bricofoy/groupe/kicad/groupe2/groupe2.png

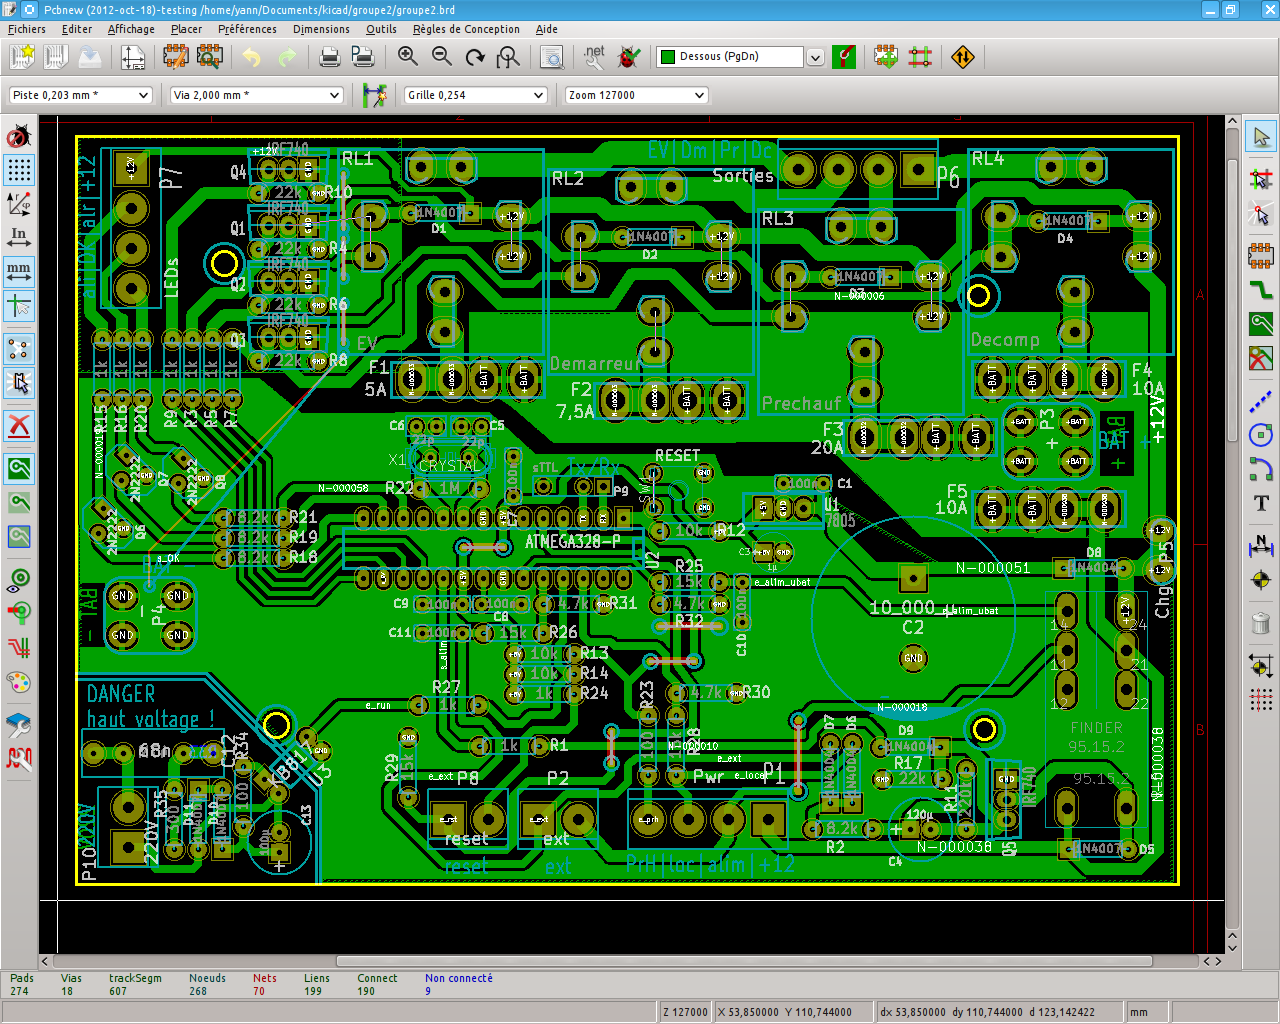
kicad/groupe2/groupe2.png
