bricofoy/groupe/kicad/groupe2/groupe2.pdf

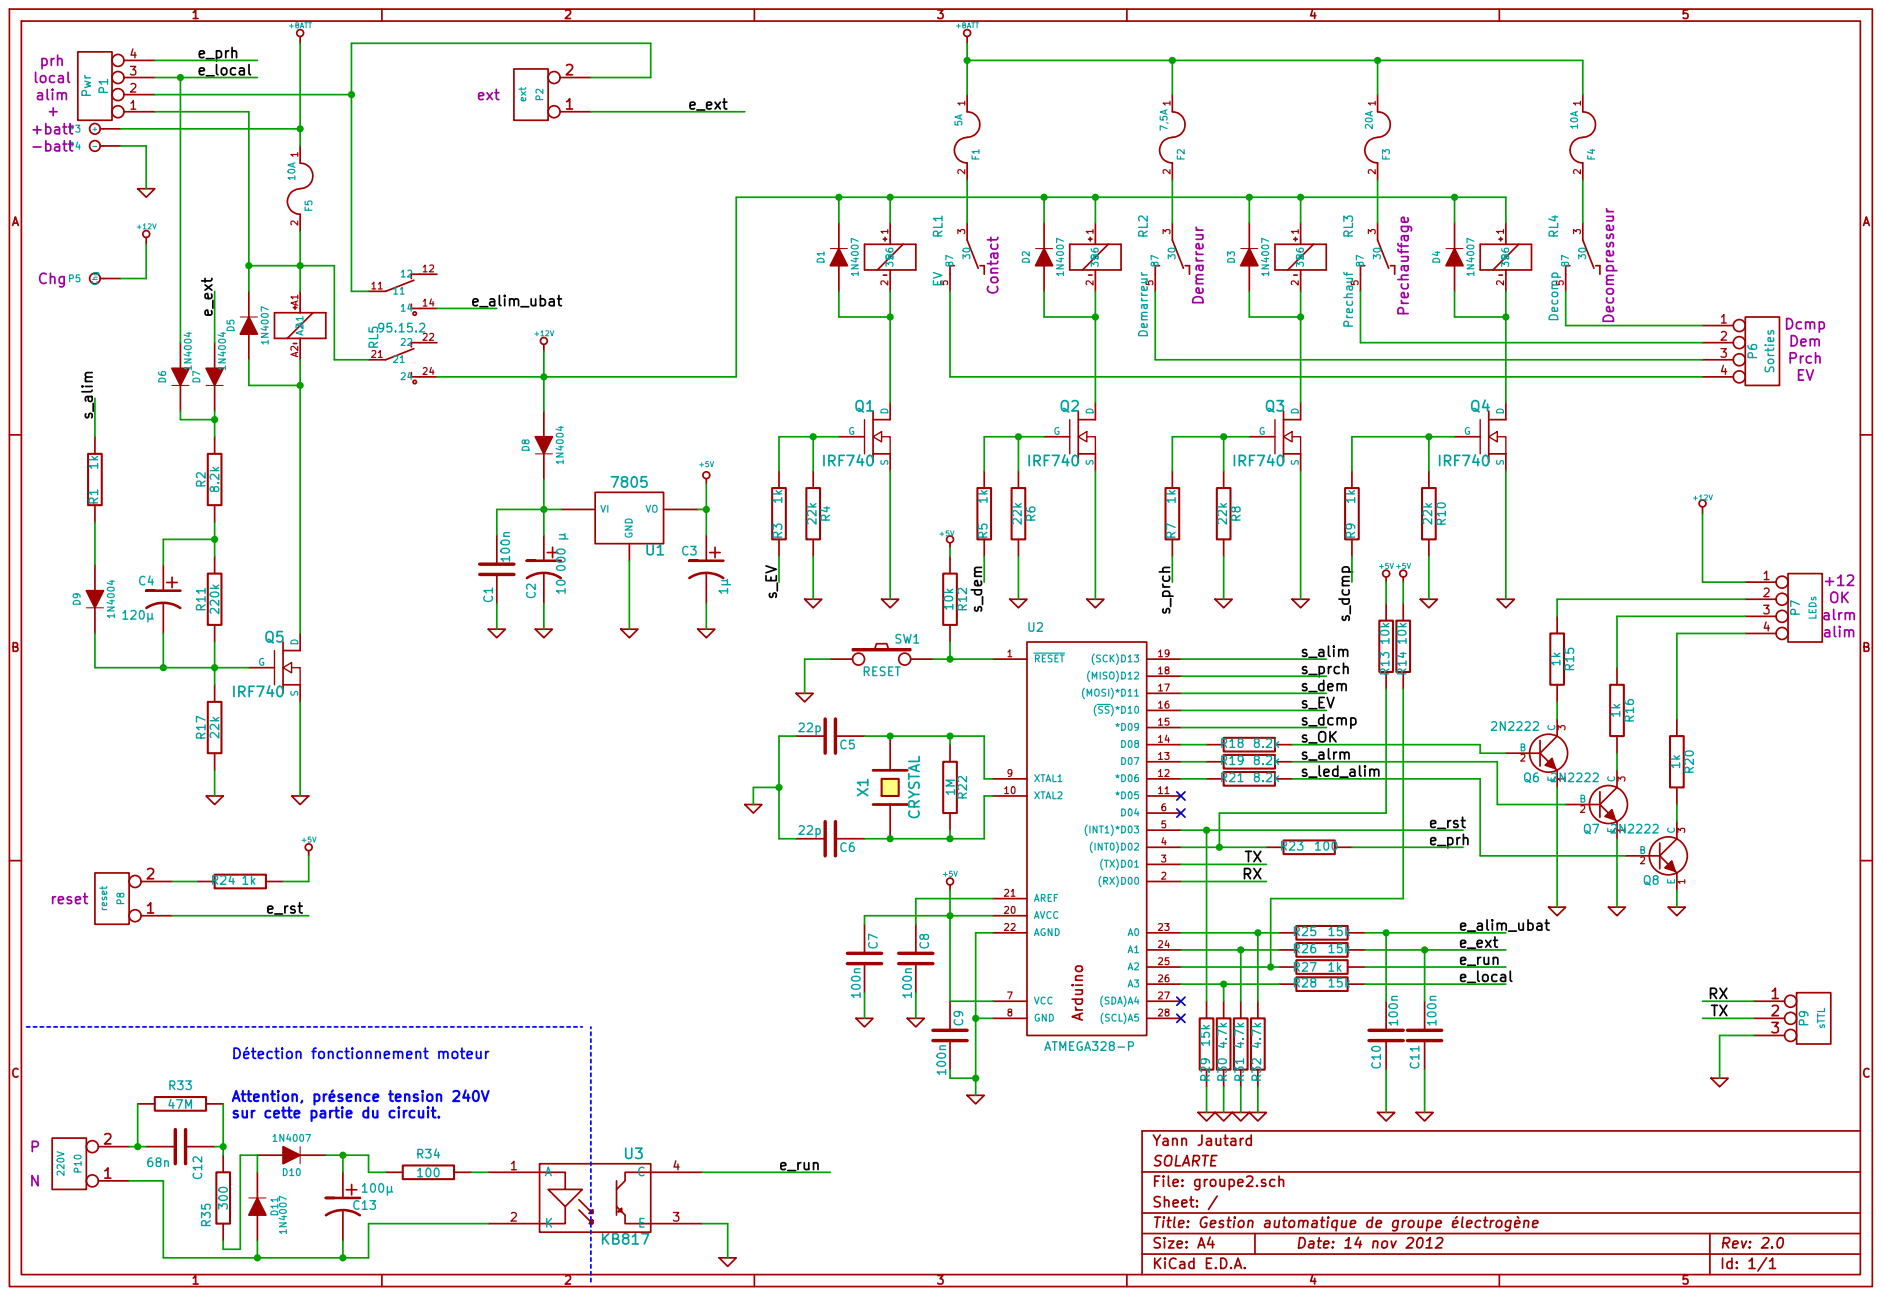
[picture p2: page 1]

SOLARTE
File: groupe2.sch
Sheet: /
Title: Gestion automatique de groupe électrogène
