bricofoy/groupe/kicad/groupe2/pcb/groupe2-Dessous.pdf

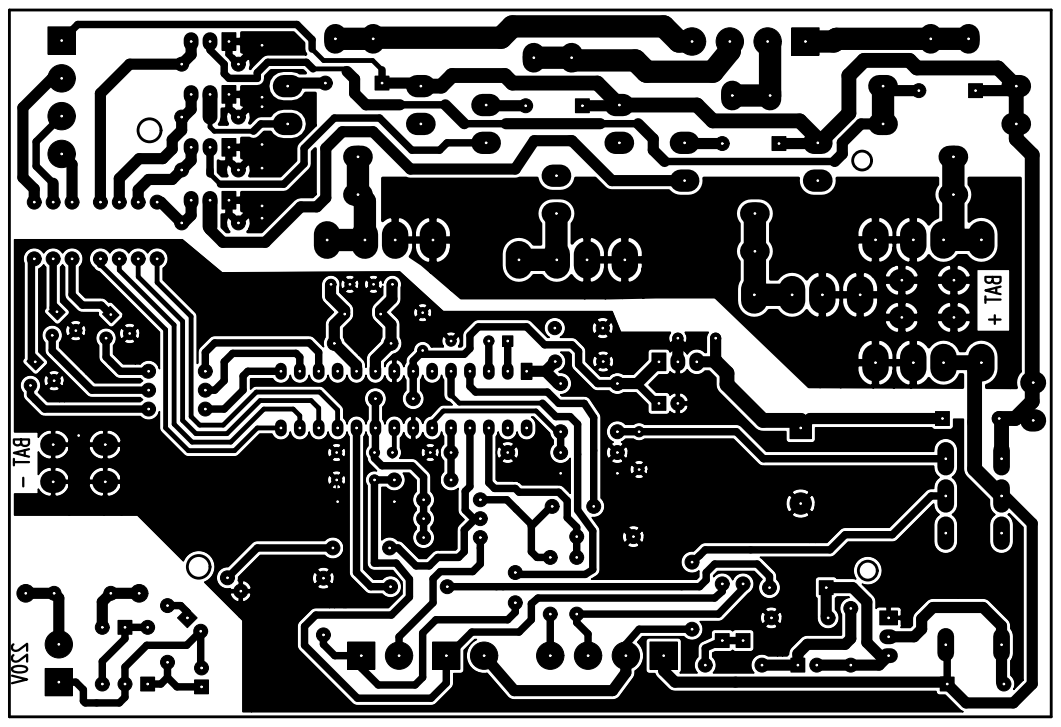
[picture p3: page 1]
