bricofoy/groupe/kicad/groupe2/pcb/groupe2-SilkS_Back.pdf

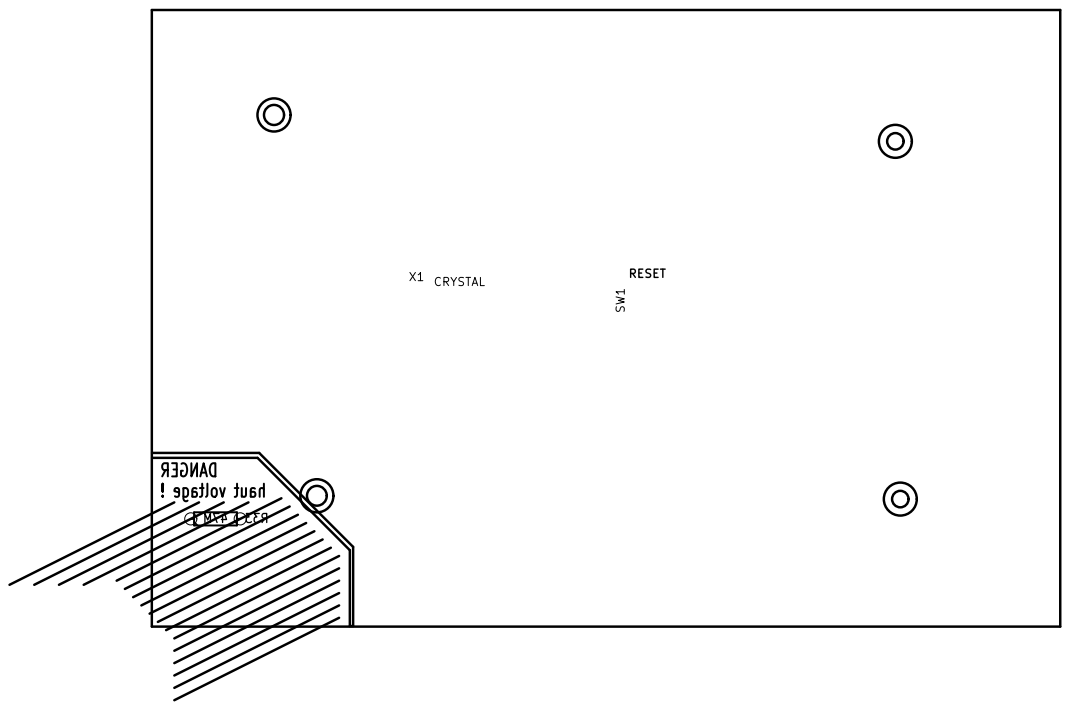
[picture p4: page 1]
