bricofoy/groupe/kicad/groupe2/pcb/groupe2-SilkS_Front.pdf

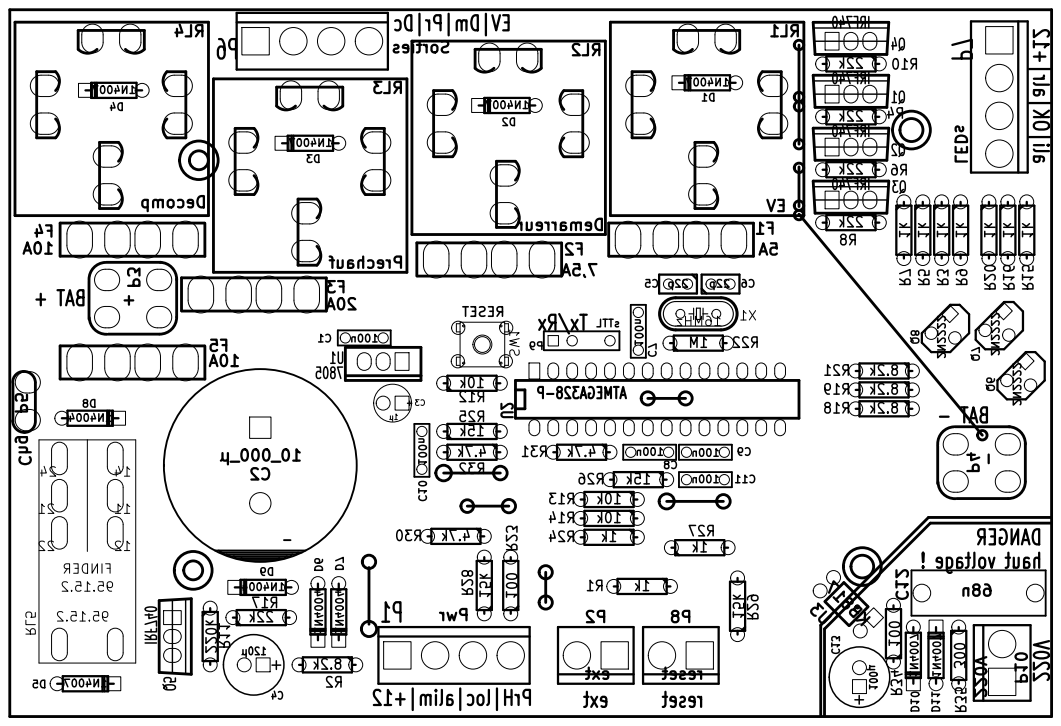
[picture p5: page 1]
