bricofoy/groupe/kicad/groupe2/groupe2.sch

## KiCad design kicad/groupe2/groupe2.sch (2013-01-15)

Schematic: groupe2.sch

Parts:
C1, C7, C8, C9, C10, C11: 100n; cnp_18x6mm
C2: 10 000 µ; C1V5
C3: 1µ; C1V5
C4: 120µ; C1V8
C5, C6: 22p; cnp_18x6mm
C12: 68n; cnp_18x6mm
C13: 100µ; C1V8
D1, D2, D3, D4, D5, D10, D11: 1N4007; D3
D6, D7, D8, D9: 1N4004; D3
F1: 5A; fus_auto_3522-2
F2: 7,5A; fus_auto_3522-2
F3: 20A; fus_auto_3522-2
F4, F5: 10A; fus_auto_3522-2
P1: Pwr; bornier4
P2: ext; bornier2
P3: +; borne_vis_Keystone_7698
P4: -; borne_vis_Keystone_7698
P5: Chg; borne_vis_Keystone_7698
P6: Sorties; bornier4
P7: LEDs; bornier4
P8: reset; bornier2
P9: sTTL
P10: 220V; bornier2
Q1, Q2, Q3, Q4, Q5: IRF740; TO220V-GDS
Q6, Q7, Q8: 2N2222; TO92-123
R1, R3, R5, R7, R9, R15, R16, R20, R24, R27: 1k; R3
R2, R18, R19, R21: 8.2k; R3
R4, R6, R8, R10, R17: 22k; R3
R11: 220k; R3
R12, R13, R14: 10k; R3
R22: 1M; R3
R23, R34: 100; R3
R25, R26, R28, R29: 15k; R3
R30, R31, R32: 4.7k; R3
R33: 47M; R3
R35: 300; R3
RL1: EV; relais_auto_1R_faston_TE_1217080-1
RL2: Demarreur; relais_auto_1R_faston_TE_1217080-1
RL3: Prechauf; relais_auto_1R_faston_TE_1217080-1
RL4: Decomp; relais_auto_1R_faston_TE_1217080-1
RL5: 95.15.2; relay_finder-95.15.2
SW1: RESET
U1: 7805
U2: ATMEGA328-P; DIL28
U3: KB817; opto_dil4
X1: CRYSTAL

Notes on the sheet:
Détection fonctionnement moteur
Attention, présence tension 240V sur cette partie du circuit.
