bricofoy/groupe/(commit log)

2013-01-15 commit initial depuis l'état courant du projet
    [groupe2.brd, groupe2.sch]
2013-03-05 nouvelle version fichier pcb kicad
    [groupe2.kicad_pcb]
2013-03-05 fin essai
    [groupe2.brd, groupe2.kicad_pcb]
2013-05-07 30-04-2013 | bricofoy@free.fr | 1.0.0 | Ajout tempo de chauffage et refroidissement moteur + commande relais | | | coupure sortie commandé par s_dec (mais tout ça c'est pas fini !! en fait juste des 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
    [groupe.ino]
2013-05-10 Version 1.0.0
    Ajout tempo de chauffage et refroidissement moteur + commande relais coupure sortie commandé par s_out
    renommage s_dec --> s_out vs_decmp --> vs_out
    ajout tempo sur détection défaut PrH pour éviter détection PrH au lieu de calage
2013-05-13 1.0.0 finale qui fonctionne
    -démarrage sur commande externe, moteur tourne min avant activation sortie, puis 3min après coupure sortie lorsque la demande disparait.
    -si la demande revient avant arret moteur -> réactivation sortie immédiate
    -lors des phase de chauffe et refroidissement moteur, la diode verte clignote. clignotement lent pdt la chauffe, rapide pdt le refroidissement.
2013-05-15 corrections de formattage pour faciliter la lecture du code
    [groupe.ino]
2013-05-16 Mise à jour du fichier utilisation.
    Mise à jour du fihier utilisation pour correspondre au comportement de la version 1.0.0
    Supression de deux fichier obsolètes.
